terryfurqan/orbital-shaker/Langkah_Kerja_Perakitan_Orbital_Shaker.pdf

# PANDUANLENGKAPLANGKAHKERJA

# PERAKITAN & KALIBRASIDIYDIGITAL

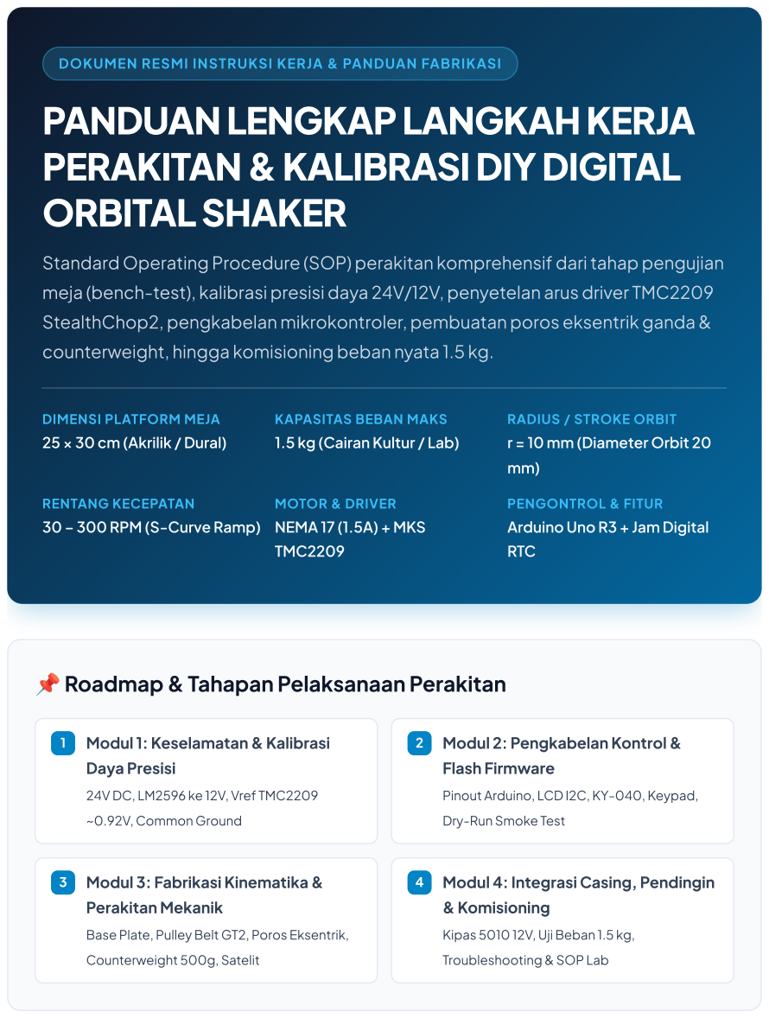
[picture p1: page 1]
ORBITALSHAKER; RENTANG KECEPATAN; MOTOR & DRIVER; NEMA 17 (1.5A) + MKS; TMC2209; PENGONTROL & FITUR; RTC; Modul 1: Keselamatan & Kalibrasi; Daya Presisi; ~0.92V, Common Ground; Modul 2: Pengkabelan Kontrol &; Flash Firmware; Modul 3: Fabrikasi Kinematika &; Perakitan Mekanik; Counterweight 500g, Satelit; Modul 4:Integrasi Casing, Pendingin; & Komisioning

DOKUMEN RESMI INSTRUKSI KERJA & PANDUAN FABRIKASI

Standard Operating Procedure (SOP) perakitan komprehensif daritahap pengujian

meja (bench-test), kalibrasi presisi daya 24V/12V, penyetelan arus driver TMC2209

StealthChop2, pengkabelan mikrokontroler, pembuatan poros eksentrik ganda &

counterweight, hingga komisioning beban nyata 1.5 kg.

DIMENSI PLATFORM MEJA

KAPASITAS BEBAN MAKS

RADIUS / STROKE ORBIT

25 × 30 cm (Akrilik / Dural)

1.5 kg (Cairan Kultur / Lab)

r = 10 mm (Diameter Orbit 20

30 – 300 RPM (S-Curve Ramp)

Arduino Uno R3 + Jam Digital

📌Roadmap & Tahapan Pelaksanaan Perakitan

24V DC, LM2596 ke 12V, Vref TMC2209

Pinout Arduino, LCD I2C, KY-040, Keypad,

Dry-Run Smoke Test

Base Plate, PulleyBelt GT2, Poros Eksentrik,

Kipas 5010 12V, UjiBeban 1.5 kg,

Troubleshooting & SOP Lab

📋

## Audit Kesiapan Bahan & Perlengkapan (Checklist

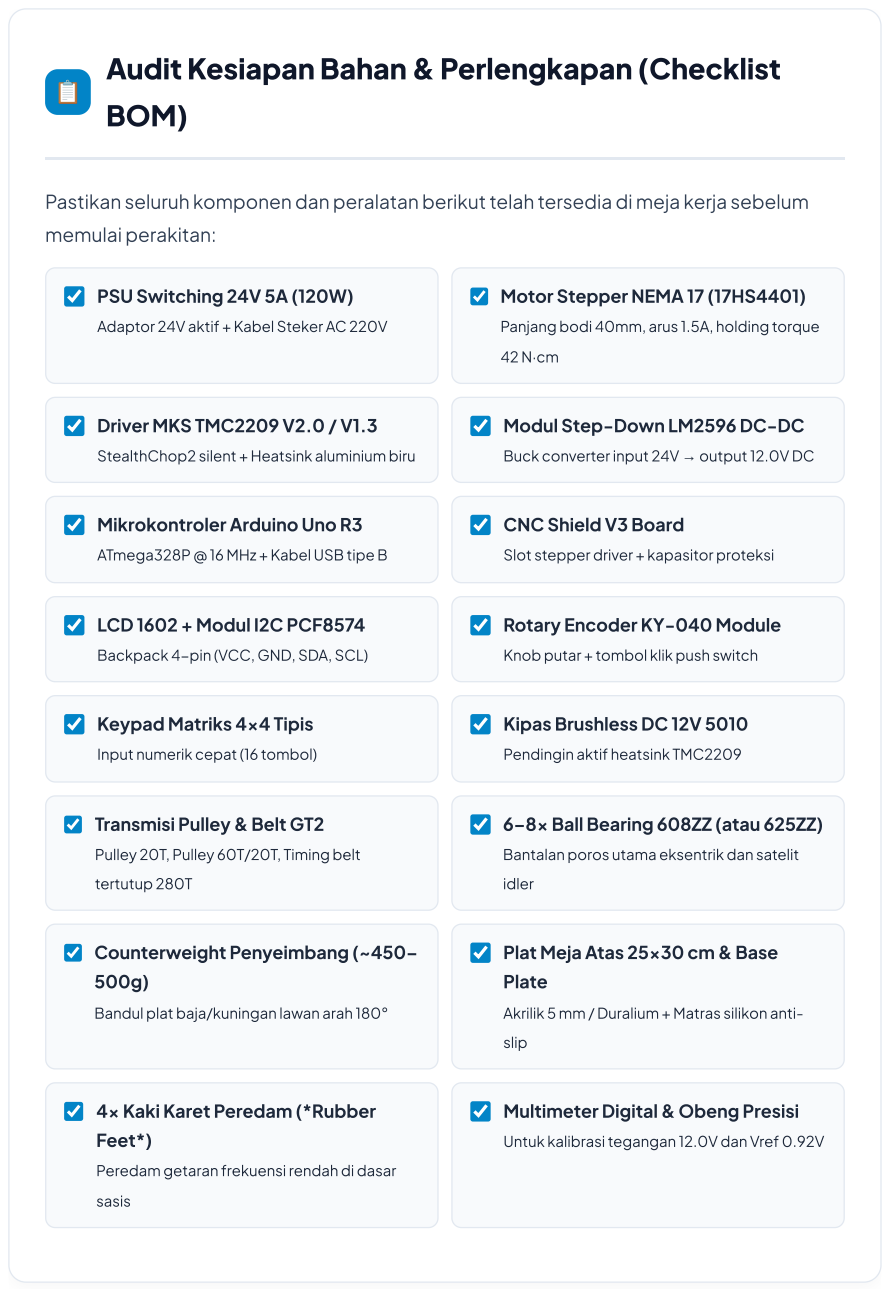
[picture p2: page 2]
BOM); memulai perakitan:; PSU Switching 24V 5A (120W); Driver MKS TMC2209 V2.0 / V1.3; LCD 1602 + Modul I2C PCF8574; tertutup 280T; idler; Counterweight Penyeimbang (~450–; Plate; slip; Feet*); sasis

Pastikan seluruh komponen dan peralatan berikuttelah tersedia di meja kerja sebelum

Motor Stepper NEMA 17 (17HS4401)

Adaptor 24V aktif + Kabel Steker AC 220V

Panjang bodi 40mm, arus 1.5A, holding torque

Modul Step-Down LM2596 DC-DC

Buck converter input 24V → output12.0V DC

StealthChop2 silent + Heatsink aluminium biru

Mikrokontroler Arduino Uno R3

CNC Shield V3 Board

ATmega328P @ 16 MHz + Kabel USBtipeB

Slot stepper driver + kapasitor proteksi

Rotary Encoder KY-040 Module

Backpack 4-pin (VCC, GND, SDA, SCL)

Knob putar + tombol klik push switch

Keypad Matriks 4×4 Tipis

Kipas Brushless DC 12V 5010

Input numerik cepat(16 tombol)

Pendingin aktif heatsink TMC2209

Transmisi Pulley & Belt GT2

6–8x Ball Bearing 608ZZ (atau 625ZZ)

Pulley 20T, Pulley 60T/20T, Timing belt

Bantalan poros utama eksentrik dan satelit

Plat Meja Atas 25×30 cm & Base

Bandul plat baja/kuningan lawan arah 180°

Akrilik 5 mm / Duralium + Matras silikon anti-

4x Kaki Karet Peredam (*Rubber

Multimeter Digital & Obeng Presisi

Untuk kalibrasitegangan 12.0V dan Vref 0.92V

Peredam getaran frekuensi rendah di dasar

1

TAHAP 1 • PRE-FLIGHT BENCH TEST

## Keselamatan Kerja, Distribusi Daya 24V & Kalibrasi

## Elektronik Presisi

Kegagalan pada tahap distribusi daya tegangan tinggi (220V AC) atau kesalahan polaritas

tegangan DC (24V/12V/5V) dapat berakibatfatal: sengatan listrik, kebakaran akibat

short-circuit, atau kerusakan permanen pada IC mikrokontroler (Arduino ATmega328P)

dan MOSFET driver motor (TMC2209). Lakukan audit keselamatan secara ketat sebelum

mencolokkan steker ke sumber daya PLN.

1.1 Keselamatan Penanganan Listrik AC 220V & Proteksi Terminal

⚠️ BAHAYA TEGANGAN TINGGI(220V AC LETHAL VOLTAGE): Terminal input AC

pada PSU jaring dalam kondisiterbuka.Jangan pernah menyentuh terminal kabel

atau bodi logam saat kabel stekerterhubung ke stopkontak PLN!

- Terminal L (Line / Phase): Hubungkan ke kabelfasa AC bertegangan (warna

Cokelat/Hitam). Pasang saklar rocker dan sekering kaca 2A Slow-Blow pada jalur ini.

- Terminal N (Neutral): Hubungkan ke kabel netral AC (warnaBiru).
- Terminal FG / ⏚ (Frame Ground / Earth): Wajib dihubungkan ke kabel arde instalasi

rumah (Hijau-Kuning) untuk membuang kebocoran arus induksi pada sasis logam

PSU.

- Terminal Output DC: -V / COM adalah Ground 24V DC, dan +V adalah Positif 24V

DC. Gunakan kabel AWG 20–22 dengan skun terminal U berisolasi.

1.2 Prosedur Kalibrasi Modul Step-Down LM2596 (Wajib 12.00V DC)

Modul LM2596 bertugas menurunkan tegangan bus 24V DC dari PSU menjadi 12.00V DC

yang stabil untuk mencatuKipas Pendingin DC 12V 5010 dan Pin VIN Arduino Uno.

🚫 PERINGATAN KRITIKAL:Banyak modul LM2596 baru dari pabrik memiliki setelan

trimpot pada batas atas (~23.5V).JANGAN PERNAH menghubungkan output

LM2596 ke pin VIN Arduino atau Kipas 12V sebelum tegangan diukur dan dikunci

tepat pada 12.00V! Tegangan 24V akan menghancurkan regulator Arduino dan

membakar lilitan kipas seketika.

======================== SKEMA BENCH TEST KALIBRASI LM2596

======================== [PSU JARING 24V] [MODUL LM2596 BUCK] [MULTIMETER

DIGITAL] +----------------+ +--------------------+ +--------------------+

| +V (24V DC) |-----(Kabel Merah) >| IN+ OUT+ | -[Probe Merah] >|
[VΩmA] | | | | [TRIMPOT 3296W] | | | | -V (GND 24V) |-----(Kabel Hitam)
>| IN- OUT- | -[Probe Hitam] >| [COM] [ 12.00V ] | +----------------+
+--------------------+ +--------------------+ | Putar berlawanan jarum

jam (CCW ~5-15 putaran) hingga tegangan drop ke 12.00V

1 | Isolasi Beban Output:Biarkan terminal OUT+ dan OUT- LM2596 dalam kondisi terbuka tanpa beban kabel.
2 | Sambungkan Input: Hubungkan +V PSU ke IN+ dan -V PSU ke IN- LM2596.
3 | Setting Multimeter: Atur Multimeter Digital ke mode DC Voltage (⎓ V) 20V. Tempelkan probe merah di OUT+ dan probe hitam di OUT- .
4 | Penyetelan Trimpot: Nyalakan PSU. Putar bauttrimpot kuningan (3296W) berlawanan arah jarum jam (CCW) sebanyak 5–15 putaran hingga angka tegangan drop dan terkunci di TEPAT 12.00V DC (±0.05V). Matikan PSU.

1.3 Kalibrasi Vref Driver MKS TMC2209 V2.0 (Silent Stepper)

TMC2209 menggunakan modulasi StealthChop2 untuk pergerakan motor yang senyap

tanpa desis frekuensi audio. Modul MKS TMC2209 V2.0 menggunakan Current Sense

Resistors Rsense = 0.11 Ω (kode chip SMD: 'R110').

Rumus Arus RMS & Penentuan Tegangan Vref:

$I_{\text{RMS}} = \frac{V_{\text{ref}}}{\sqrt{2} \times 8 \times

R_{\text{sense}}} = \frac{V_{\text{ref}}}{1.414 \times 8 \times 0.11}

\approx 0.8037 \times V_{\text{ref}}$

Target Arus Motor 17HS4401 (1.5A Rated): $I_{\text{RMS}} =

0.74\text{A} \implies \mathbf{V_{\text{ref}} = 0.90\text{V} -

0.95\text{V DC}}$

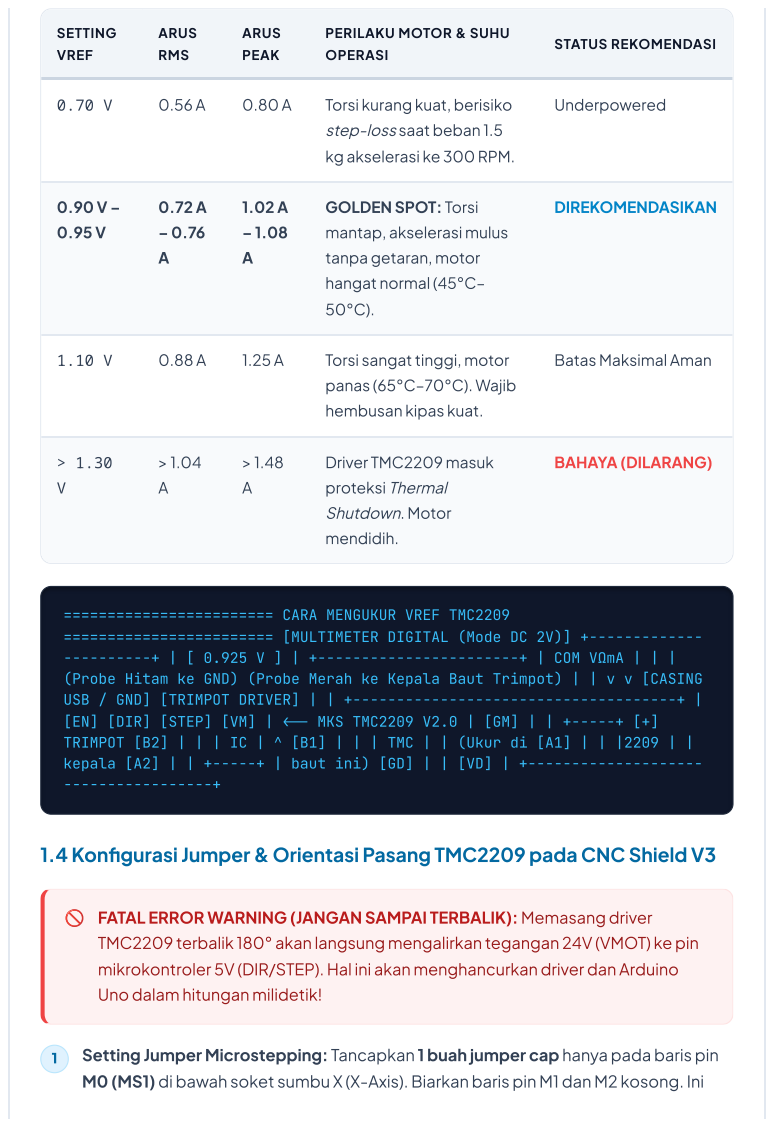
[picture p3: page 5]
SETTING; VREF; ARUS; RMS; PEAK; OPERASI; STATUS REKOMENDASI; Torsi kurang kuat, berisiko; Underpowered; hangat normal (45°C–; DIREKOMENDASIKAN; Torsi sangattinggi, motor; panas (65°C–70°C). Wajib; Driver TMC2209 masuk; proteksi Thermal; Shutdown. Motor; mendidih.; BAHAYA (DILARANG); Setting Jumper Microstepping: Tancapkan 1 buah jumper cap hanya pada baris pin

PERILAKU MOTOR & SUHU

step-loss saat beban 1.5

kg akselerasi ke 300 RPM.

GOLDEN SPOT: Torsi

mantap, akselerasi mulus

tanpa getaran, motor

Batas Maksimal Aman

hembusan kipas kuat.

======================== CARA MENGUKUR VREF TMC2209
======================== [MULTIMETER DIGITAL (Mode DC 2V)] +-------------

----------+ | [ 0.925 V ] | +-----------------------+ | COM VΩmA
(Probe Hitam ke GND) (Probe Merah ke Kepala Baut Trimpot) | | v v [CASING

USB / GND] [TRIMPOT DRIVER] | | +-------------------------------------+

[EN] [DIR] [STEP] [VM] | - MKS TMC2209 V2.0 | [GM] | | +-----+ [+]
TRIMPOT [B2] | | | IC | ^ [B1] | | | TMC | | (Ukur di [A1] | | |2209

kepala [A2] | | +-----+ | baut ini) [GD] | | [VD] | +--------------------

1.4 KonfigurasiJumper & Orientasi Pasang TMC2209 pada CNC Shield V3

🚫 FATAL ERROR WARNING (JANGAN SAMPAI TERBALIK): Memasang driver

TMC2209 terbalik 180° akan langsung mengalirkan tegangan 24V (VMOT) ke pin

mikrokontroler 5V (DIR/STEP). Hal ini akan menghancurkan driver dan Arduino

Uno dalam hitungan milidetik!

M0 (MS1) di bawah soket sumbu X (X-Axis).Biarkan baris pin M1 dan M2 kosong. Ini

mengaktifkan mode 1/16 Microstepping dengan interpolasi1/256 StealthChop2.

2 | Verifikasi Pinout Driver: Pastikan pin bertuliskan EN pada driver menancap ke lubang EN CNC Shield, dan pin DIR ke lubang DIR . Trimpot baut potensiometer pada MKS TMC2209 V2.0 menghadap ke arah bawah (menjauhi kapasitor biru besar CNC Shield).
3 | Pemasangan Heatsink:Bersihkan chip TMC2209, rekatkan heatsink aluminium biru tepat ditengah. Pastikan sirip heatsink tidak menyentuh pin header logam di sekelilingnya.

1.5 Arsitektur Titik Referensi Bersama (Star Common Ground)

Sistem beroperasi dengan 3 domain tegangan: 24V (Motor),12V (Kipas/VIN), dan 5V

(Logika MCU). Seluruh kutub negatif(GND) WAJIB dihubungkan bersama ke satu titik

referensi(Common Ground) untuk mencegah floating voltage yang menyebabkan sinyal

clock terganggu.

======================== TOPOLOGI STAR COMMON GROUND ======================== [PSU JARING 24V] Terminal [-V] (GND 24V) │

├───(Kabel AWG 20)───► [LM2596 BUCK CONVERTER] │ Terminal [IN-] & [OUT-]

(Internal Common GND) │ │ │ ├───(AWG 22)───► [KIPAS 12V (Kabel Hitam -)]

│ │ │ └───(AWG 22)───► [ARDUINO UNO (Pin GND)] │ │ └───(Kabel AWG 20)───►

[CNC SHIELD V3] ├──► [LCD 1602 GND] Terminal Power GND ◄───────────┼──►

[ROTARY ENCODER GND] & Soket TMC2209 GND └──► [KEYPAD GROUND (Internal)]

## Pengkabelan Sistem Kontrol, Flash Firmware & Dry-

## Run Bench Test

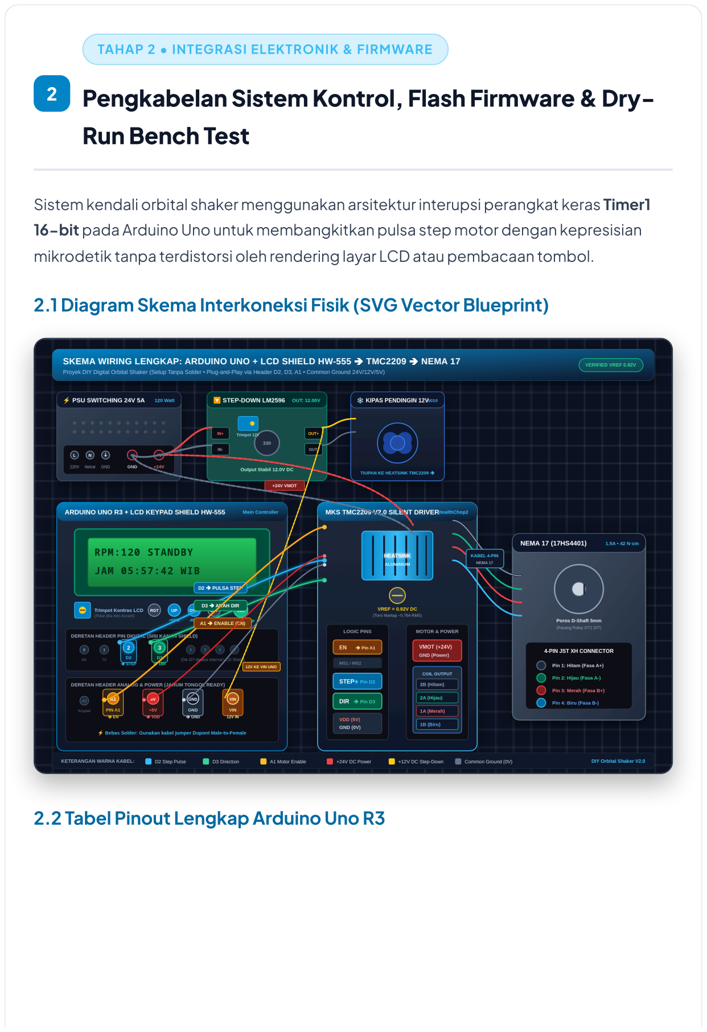
[picture p4: page 7]
VERIFIED VREF 0.92V; +24V VMOT; D2 ➔ PULSA STEP; D3 ➔ ARAH DIR; A1 ➔ ENABLE (EN); KABEL 4-PIN NEMA 17; KETERANGAN WARNA KABEL:; D2 Step Pulse; D3 Direction; A1 Motor Enable; +24V DC Power; +12V DC Step-Down; Common Ground (0V); DIY Orbital Shaker V2.0

TAHAP 2 • INTEGRASI ELEKTRONIK & FIRMWARE

Sistem kendali orbital shaker menggunakan arsitektur interupsi perangkat keras Timer1

16-bit pada Arduino Uno untuk membangkitkan pulsa step motor dengan kepresisian

mikrodetik tanpa terdistorsi oleh rendering layar LCD atau pembacaan tombol.

2.1 Diagram Skema Interkoneksi Fisik (SVG Vector Blueprint)

SKEMA WIRING LENGKAP: ARDUINO UNO + LCD SHIELD HW-555 ➔ TMC2209 ➔ NEMA 17

Proyek DIY Digital Orbital Shaker (Setup Tanpa Solder • Plug-and-Play via Header D2, D3, A1 • Common Ground 24V/12V/5V)

12V KE VIN UNO

2.2 Tabel Pinout Lengkap Arduino Uno R3

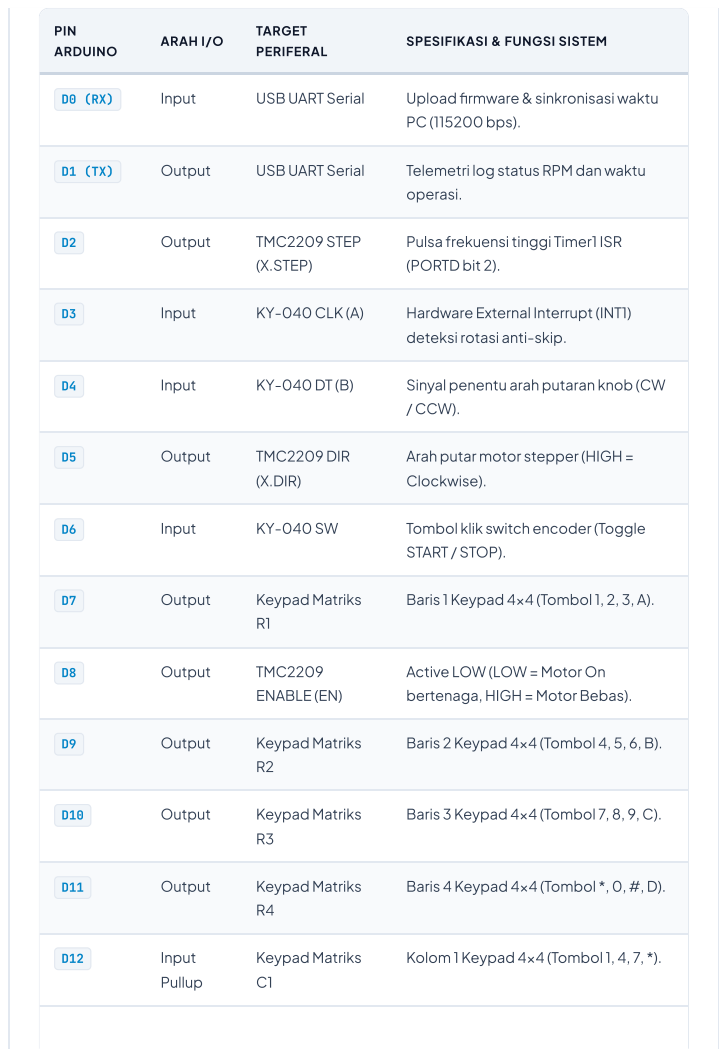
[picture p5: page 8]

deteksi rotasi anti-skip.

Arah putar motor stepper (HIGH =

Active LOW (LOW = Motor On

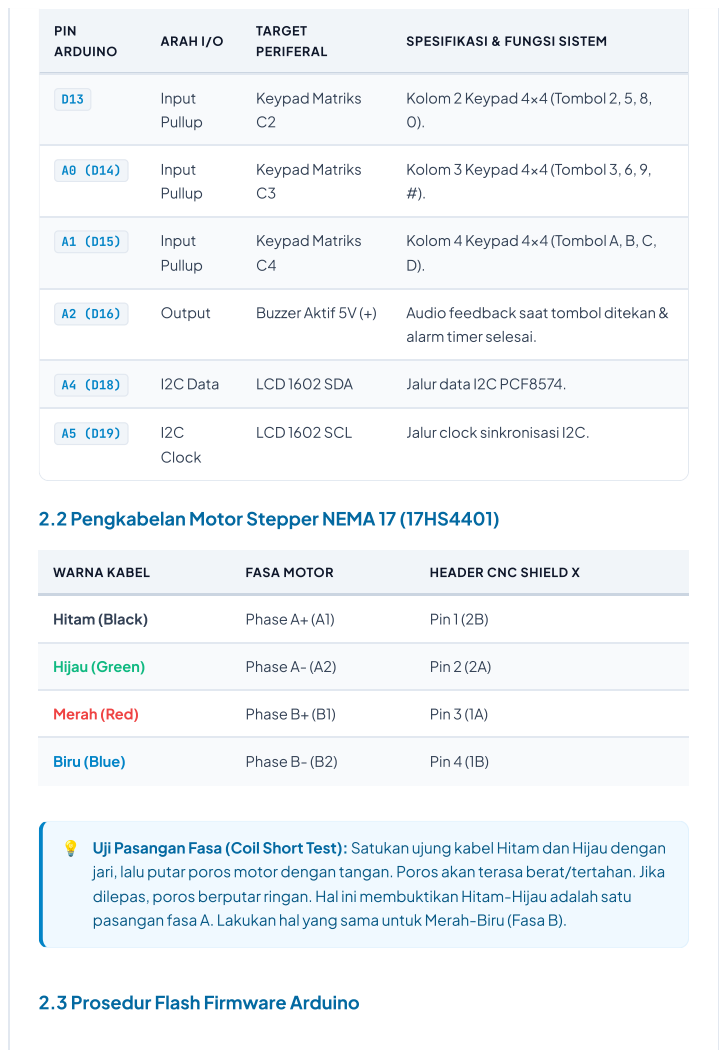
[picture p6: page 9]
Input; Pullup; Keypad Matriks; Output; Buzzer Aktif 5V (+); Audio feedback saattombol ditekan &; I2C Data; LCD 1602 SDA; Jalur data I2C PCF8574.; Clock; LCD 1602 SCL; Jalur clock sinkronisasi I2C.; WARNA KABEL; FASA MOTOR; HEADER CNC SHIELD X; Hitam (Black); Phase A+ (A1); Pin 1(2B); Hijau (Green); Phase A- (A2); Pin 2 (2A); Merah (Red); PhaseB+ (B1); Pin 3 (1A); Biru (Blue); PhaseB- (B2); Pin 4 (1B)

PIN ARDUINO | ARAH I/O | TARGET PERIFERAL | SPESIFIKASI & FUNGSI SISTEM

D13 | Input Pullup | Keypad Matriks C2 | Kolom 2 Keypad 4×4 (Tombol 2, 5, 8, 0).

Kolom 3 Keypad 4×4 (Tombol 3, 6, 9,

Kolom 4 Keypad 4×4 (Tombol A,B, C,

alarm timer selesai.

2.2 Pengkabelan Motor Stepper NEMA 17 (17HS4401)

💡 Uji Pasangan Fasa (Coil Short Test): Satukan ujung kabel Hitam dan Hijau dengan

jari, lalu putar poros motor dengan tangan. Poros akan terasa berat/tertahan.Jika

dilepas, poros berputar ringan. Hal ini membuktikan Hitam-Hijau adalah satu

pasangan fasa A. Lakukan hal yang sama untuk Merah-Biru (FasaB).

2.3 Prosedur Flash Firmware Arduino

1 Buka folder sketch Arduino code/orbital_shaker/orbital_shaker.ino pada

Arduino IDE.

2 Buka tab config.h , pastikan #define USE_LCD_KEYPAD_SHIELD false (jika

menggunakan LCD I2C + CNC Shield) dan periksa alamat LCD_I2C_ADDR 0x27 .

3 Pilih board Arduino Uno dan Port COM yang sesuai, lalu tekan tombol Upload (Ctrl +

U).Jam digital internal otomatis disinkronisasi dari waktu kompilasi komputer

( _TIME _ ).

4 | Buka Serial Monitor (115200 baud). Pastikan muncul pesan inisialisasi: | [System
Ready.] | .

2.4 Prosedur Dry-Run Smoke Test (Tanpa Beban Mekanik)

1 | Tes Display LCD: Colokkan USBArduino. Putartrimpot kontras biru di belakang LCD I2C hingga teks terbaca tajam:Baris 1: RPM:120 STANDBY ,Baris 2: JAM 06:50:00 WIB (detik berdetik lancar).
2 | Tes Rotary Encoder: Putar knob searah jarum jam (RPM bertambah +5 RPM per klik) dan berlawanan arah jarum jam (RPM berkurang). Tekan tombol knob encoder untuk memulai putaran motor.
3 | Tes Respon Motor Stepper: Nyalakan PSU 24V. Saat start ditekan, motor berakselerasi lembut selama 2 detik (Ramp-Up S-Curve) hingga mencapai120 RPM. Suara motor harus sangat senyap (StealthChop2)tanpa getaran sentak. Tekan stop, motor melambatlembut selama 1.5 detik hingga berhenti penuh.

3

TAHAP 3 • FABRIKASI & PERAKITAN MEKANIKAL

## Fabrikasi Kinematika, Desain Eksentrik & Perakitan

## Mekanikal Total

Gerakan pada Orbital Shaker secara fisis adalah Pure Circular Translation (Translasi

Melingkar Murni), bukan rotasi/putaran poros (*spin*). Setiap titik di permukaan meja

membentuk lingkaran berdiameter $20\text{ mm}$ ($r = 10\text{ mm}$) dengan orientasi

arah meja selalu konstan terhadap kerangka laboratorium ($\omega_{\text{self-

rotation}} = 0$).

KINEMATIKA PERGERAKAN MEJA (PURE TRANSLATION vs ROTASI POROS): [Gerakan

Orbital Shaker: TRANSLASI] [Gerakan Meja Putar: ROTASI SPINNIG] A1 ------

---> A2 (t = T/4) A1 --------- B1 | | | ^ | | [MEJA] | (Orientasi Utuh, |
| | (Meja memuntir, | | tidak berputar) | (+Poros) | orientasi sumbu v v

v v berubah liar) A4 <--------- A3 (t = T/2) A2 --------- B2 Lintasan

Titik A: Lingkaran Planar (r=10mm) Lintasan Titik A: Berputar terhadap

titik tengah Orientasi Sumbu: Tetap Sejajar Lab Frame Orientasi Sumbu:

Berotasi 360 Derajat

3.1 Persiapan Rangka Dasar(Base Plate) & Kaki Karet Peredam

- Pasang 4x Kaki Karet Peredam Getaran (*Rubber Feet*) di 4 sudutterluarBase

Plate menggunakan baut countersunk M4 × 16 mm dan mur Nyloc M4. Kaki karet

menyerap gelombang mekanik 0.5–5 Hz dan mencegah alat bergeser di atas meja

(*anti-walking*).

- Buatlubang slot geser memanjang ($4.2 \times 12\text{ mm}$) untuk dudukan baut

NEMA 17 agar jarak sumbu belt dapat disetel ±6 mm.

3.2 Perakitan Transmisi Pulley & Timing Belt GT2

1 | Pasang Pulley GT2 20T Bore 5mm pada poros D-shaft motor NEMA 17. Kencangkan 2x grub screw M3 tepat pada bidang rata D-shaft dengan Loctite 242 (Blue Threadlocker).
2 | Pasang Pulley GT2 60T (atau 20T rasio 1:1) Bore 8mm pada poros penggerak utama.
3 | Pasang Timing Belt GT2 Loop Tertutup 280 mm melingkar pada kedua pulley. Tarik
| motor menjauhi poros pusat dengan gaya regang sedang (~15–20 N). Defleksi sabuk

yang ideal adalah 1.5 – 2.5 mm saat ditekan dengan jaritengah. Kencangkan 4 baut

M3 motor secara menyilang.

3.3 Desain Central Drive Hub & Counterweight Balancing (~500 Gram)

Ketika meja atas memikul sampel cairan ($1.5\text{ kg}$),total massa yang berorbit

adalah $\approx 2.0\text{ kg}$. Pada 300 RPM ($\omega = 31.4\text{ rad/s}$), gaya

sentrifugal yang timbul mencapai $F_{\text{cf}} = m \cdot \omega^2 \cdotr \approx

20\text{ Newton} \approx 2\text{ kg-force}$ yang berputar 5 kali per detik.

⚠️ MUTLAK WAJIB MEMASANG COUNTERWEIGHT: Tanpa counterweight

penyeimbang, gaya dinamis 20 N akan menggetarkan meja secara destruktif dan

membanting sasis. Counterweight ~450 – 500 gram wajib dipasang pada poros

utama tepat berlawanan arah 180° dari pin eksentrik platform!

DIAGRAM POTONGAN SENTRAL DRIVE HUB & COUNTERWEIGHT: [TOP PLATE / MEJA

ATAS 25x30 cm] | +----------- -----------+ | Ball Bearing 608ZZ | -
Pin Eksentrik (Offset r = 10 mm) +----------- -----------+ | (Pin
r=10mm) +---------------------- +-------------------------------+ | | |
POROS UTAMA (Sumbu Putar 0) | = COUNTERWEIGHT = | | | | (Massa: ~450-
500 gram, | | | | Arah: Tepat 180 DEG) +-------------| |-----------------
----------------------+ | | +--------| |--------+ | Bearing Base Plate|
+-------------------+ | | (Poros Bawah Dia 8mm) [ Pulley GT2 60T ]

3.4 Perakitan Satellite Idlers (Penjaga Orientasi Meja)

Untuk mencegah meja memuntir (*anti-rotation*) dan menjamin translasi paralel murni,

pasang 4 unit Satellite Idler Bearings (608ZZ) di 4 sudutBase Plate dengan offset

eksentrik identik $r = 10.0\text{ mm}$.

⚡ ATURAN SINKRONISASI SUDUT FASE: Saat memasang Top Plate pertama kali,

pastikan seluruh pin eksentrik satelitidler dan poros pusat menghadap ke arah

sudutfase yang SAMA PERSIS (0°, menunjuk ke arah jam 3). Deviasi sudut akan

mengunci meja (*mechanical binding*).

3.5 Pemasangan Top Plate (25 × 30 cm) & Uji Manual Zero-Binding

1 | Pasang Top Plate akrilik/aluminium $250 \times 300\text{ mm}$ ke bagian atas
| bearing eksentrik menggunakan baut M4 / M5 Stainless Steel dan Mur Pengunci
| Nyloc. (Jangan pernah gunakan mur standartanpa pengunci karena akan kendur
| akibat getaran 5 Hz).

2 | Rekatkan Silicone Mat Anti-Slip ($240 \times 290\text{ mm}$) pada permukaan atas Top Plate menggunakan perekat 3M.
3 | Uji Manual Putaran Jari(*Zero-Binding Test*): Putar pulley utama dengan jaritangan sebanyak 5–10 putaran sebelum menyalakan motor. Putaran harus terasa sangatlicin (*butter-smooth*),tanpa hentakan atau titik sempit(*tight spots*).Jika terasa berat, kendurkan sedikit baut satelit, putar meja agar menemukan self-alignment, lalu kencangkan kembali.

4

TAHAP 4 • INTEGRASI, PENDINGINAN & KOMISIONING

## Integrasi Casing, Sistem Pendingin Aktif, Kalibrasi

## Beban Nyata & SOP

4.1 Penataan Kompartemen & Manajemen Kabel

- Pasang PSU 24V, Step-Down LM2596, dan Arduino + CNC Shield pada kompartemen

bawah menggunakan Standoff Isolator Nylon M3 × 10 mm.

- Pemisahan Jalur Kabel(EMI Isolation):Jalur daya AC 220V dan DC 24V dirutekan di

kompartemen kiri (kabelfasa motor dipilin/twisted pair).Jalur sinyal data mikro (LCD

I2C SDA/SCL, Encoder, Keypad) dirutekan di kompartemen kanan untuk mencegah

induksi derau.

4.2 Sistem Pendingin Aktif Driver TMC2209 (Kipas DC 12V 5010)

Pada kecepatan 300 RPM dengan beban 1.5 kg, MOSFET internal TMC2209

mendisipasikan panas secara kontinu. Tanpa hembusan udara aktif, suhu IC dapat

melebihi $120^\circ\text{C}$ dan memicu Over-Temperature Shutdown (OTSD) pada

$150^\circ\text{C}$ yang mematikan motor mendadak.

❄️ Pemasangan Kipas 12V 5010: Pasang Kipas 5010 (diberitegangan 12.0V dari

LM2596) pada bracket miring 45° berjarak 15 mm mengarah langsung meniup

heatsink aluminium TMC2209.Buat kisi intake di dinding bawah dan kisi exhaust

di dinding atas casing. Pendinginan aktifini menjaga suhu heatsink stabil di

$44^\circ\text{C} - 52^\circ\text{C}$ (sangat aman).

4.3 Prosedur Commissioning & Uji Beban Nyata (Real-Load Stress Test)

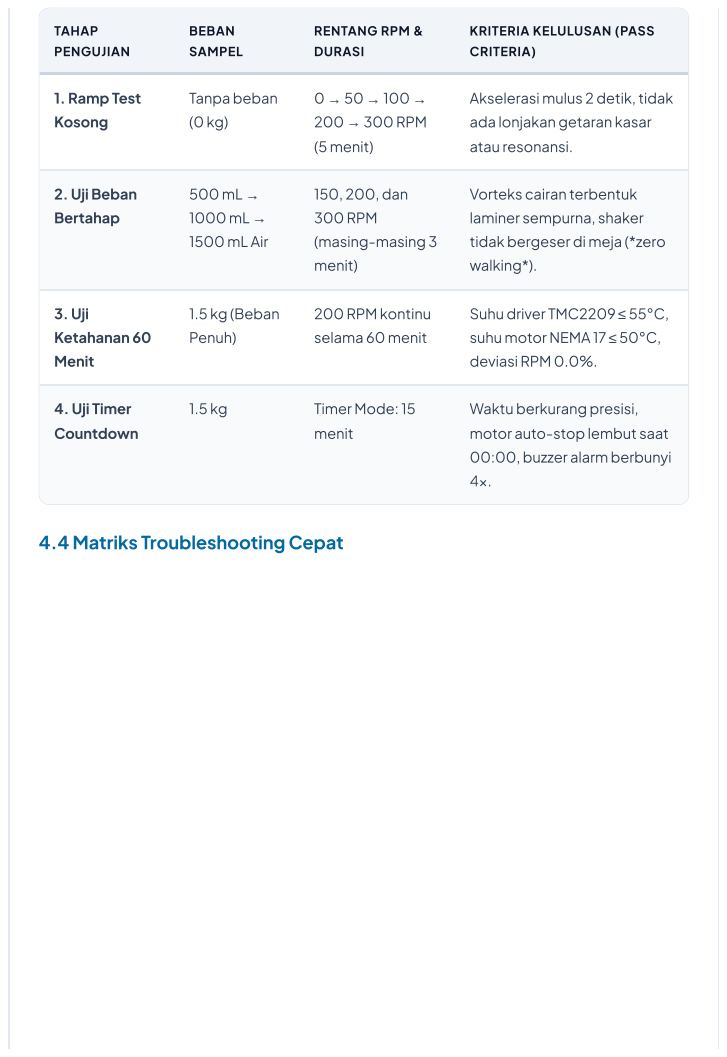
[picture p7: page 15]
TAHAP; PENGUJIAN; BEBAN; SAMPEL; RENTANG RPM &; DURASI; CRITERIA); 1. Ramp Test; Kosong; Tanpa beban; 200 → 300 RPM; (5 menit); atau resonansi.; 2. Uji Beban; Bertahap; 1500 mL Air; 150, 200, dan; 300 RPM; (masing-masing 3; menit); walking*).; 3. Uji; Ketahanan 60; Menit; 1.5 kg (Beban; Penuh); 200 RPM kontinu; selama 60 menit; Suhu driver TMC2209 ≤ 55°C,; deviasi RPM 0.0%.; 4. Uji Timer; Countdown; Timer Mode:15; menit

KRITERIA KELULUSAN (PASS

Akselerasi mulus 2 detik,tidak

ada lonjakan getaran kasar

Vorteks cairan terbentuk

laminer sempurna, shaker

tidak bergeser di meja (*zero

suhu motor NEMA 17 ≤ 50°C,

Waktu berkurang presisi,

motor auto-stop lembut saat

00:00, buzzer alarm berbunyi

4.4 Matriks Troubleshooting Cepat

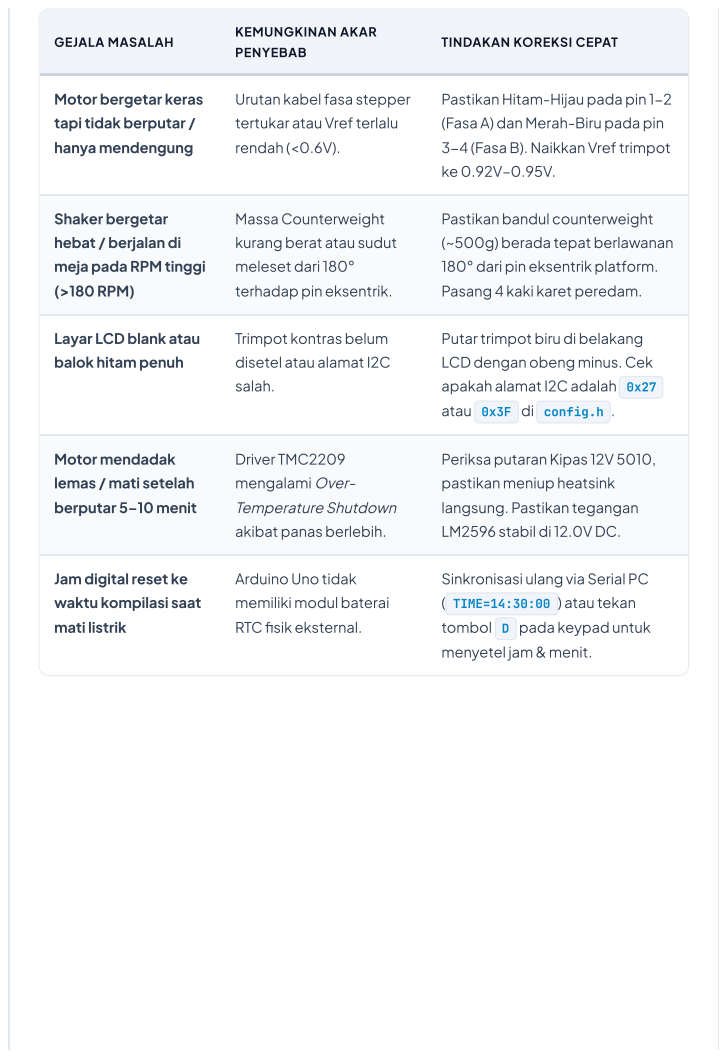
[picture p8: page 16]
GEJALA MASALAH; KEMUNGKINAN AKAR; PENYEBAB; hanya mendengung; rendah (<0.6V).; Shaker bergetar; (>180 RPM); Massa Counterweight; meleset dari180°; disetel atau alamatI2C; salah.; apakah alamatI2C adalah 0x27; Motor mendadak; berputar 5–10 menit; Driver TMC2209; mengalami Over-; Temperature Shutdown; LM2596 stabil di12.0V DC.; mati listrik

TINDAKAN KOREKSI CEPAT

Motor bergetar keras

Urutan kabelfasa stepper

Pastikan Hitam-Hijau pada pin 1-2

tapi tidak berputar /

tertukar atau Vrefterlalu

(Fasa A) dan Merah-Biru pada pin

3-4 (FasaB). Naikkan Vreftrimpot

Pastikan bandul counterweight

hebat / berjalan di

kurang berat atau sudut

(~500g) berada tepat berlawanan

meja pada RPM tinggi

180° dari pin eksentrik platform.

terhadap pin eksentrik.

Pasang 4 kaki karet peredam.

Layar LCD blank atau

Trimpot kontras belum

Putartrimpot biru di belakang

balok hitam penuh

LCD dengan obeng minus. Cek

atau 0x3F di config.h .

Periksa putaran Kipas 12V 5010,

lemas / mati setelah

pastikan meniup heatsink

langsung. Pastikan tegangan

akibat panas berlebih.

Jam digitalreset ke

Arduino Uno tidak

Sinkronisasi ulang via Serial PC

waktu kompilasi saat

memiliki modul baterai

( TIME=14:30:00 ) atau tekan

RTC fisik eksternal.

tombol D pada keypad untuk

menyetel jam & menit.

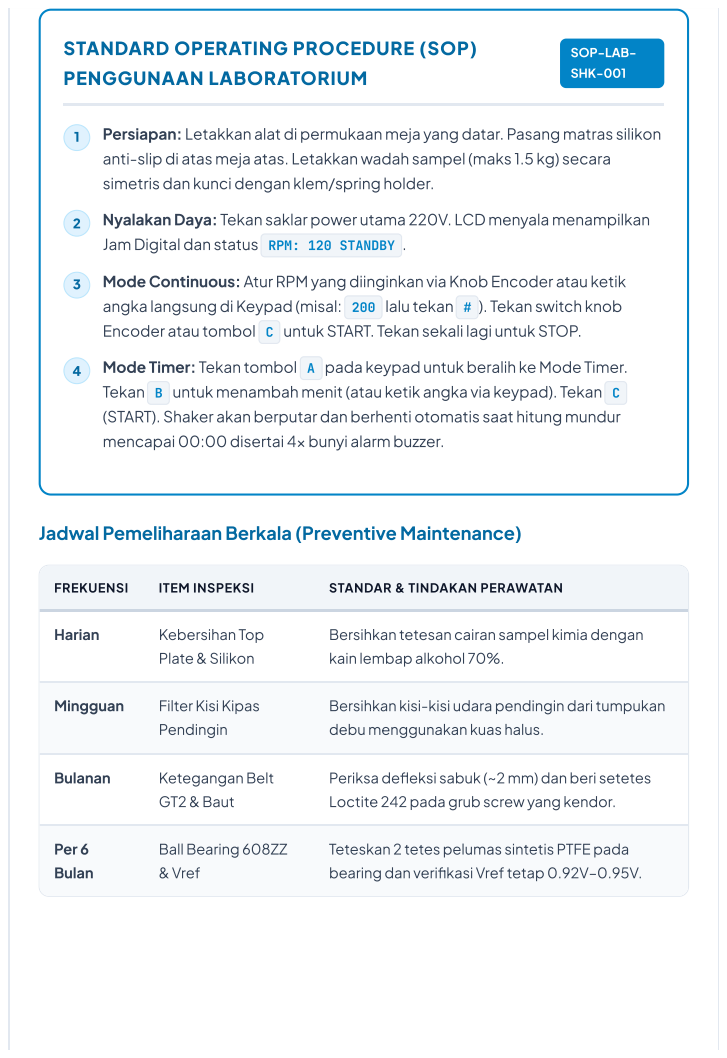
[picture p9: page 17]
PENGGUNAAN LABORATORIUM; SOP-LAB-; SHK-001; Persiapan: Letakkan alat di permukaan meja yang datar. Pasang matras silikon; Nyalakan Daya: Tekan saklar power utama 220V. LCD menyala menampilkan; Mode Continuous: Atur RPM yang diinginkan via Knob Encoder atau ketik; Mode Timer: Tekan tombol A pada keypad untuk beralih ke Mode Timer.; FREKUENSI; ITEM INSPEKSI; STANDAR & TINDAKAN PERAWATAN; Harian; Kebersihan Top; Plate & Silikon; Mingguan; Filter Kisi Kipas; Pendingin; Bulanan; KeteganganBelt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

STANDARD OPERATING PROCEDURE (SOP)

anti-slip di atas meja atas. Letakkan wadah sampel (maks 1.5 kg) secara

simetris dan kunci dengan klem/spring holder.

Jam Digital dan status RPM: 120 STANDBY .

angka langsung di Keypad (misal: 200 lalu tekan # ). Tekan switch knob

Encoder atau tombol C untuk START. Tekan sekali lagi untuk STOP.

Tekan B untuk menambah menit(atau ketik angka via keypad). Tekan C

(START). Shaker akan berputar dan berhenti otomatis saat hitung mundur

mencapai 00:00 disertai 4x bunyi alarm buzzer.

Jadwal Pemeliharaan Berkala (Preventive Maintenance)

Bersihkan tetesan cairan sampel kimia dengan

kain lembap alkohol 70%.

Bersihkan kisi-kisi udara pendingin daritumpukan

debu menggunakan kuas halus.

Periksa defleksi sabuk (~2 mm) dan beri setetes

Loctite 242 pada grub screw yang kendor.

Teteskan 2 tetes pelumas sintetis PTFE pada

bearing dan verifikasi Vreftetap 0.92V–0.95V.

Lembar Pengesahan & Quality Assurance (QA) Commissioning

Dengan menandatangani dokumen ini, seluruh tahapan kalibrasitegangan 12V, penyetelan

Vref 0.92V, perakitan mekanis eksentrik 10mm, counterweight balancing 500g, dan uji

ketahanan 60 menit beban 1.5 kg telah dinyatakan LULUS (PASS) sesuai standarteknik

mekatronika.

Dirakit & Dikalibrasi Oleh:

( | )

Lead Assembly & Calibration Engineer

Diverifikasi & Disetujui Oleh:

( | )

Laboratory Quality & Safety Officer
