terryfurqan/orbital-shaker/(commit log)

2026-09-01 feat: initial commit for DIY Digital Orbital Shaker with Arduino CLI configuration, firmware, and documentation
2026-09-01 feat: Rev 4.2 direct pulse firmware, hardware test sketches, revision log, and PowerShell test scripts
2026-09-01 fix(firmware): Rev 5.3 restore 40us/585us pure 360-degree stream without I/O jitter
    [test_360_smooth.ino]
2026-09-01 fix(firmware): Rev 5.4 360-degree safe pull-in at 6.0 RPM with standstill calibration and anti-flyback lockout
    [test_360_smooth.ino]
